mach0gr/renegade-stick/photos/complete-quickterms.jpg

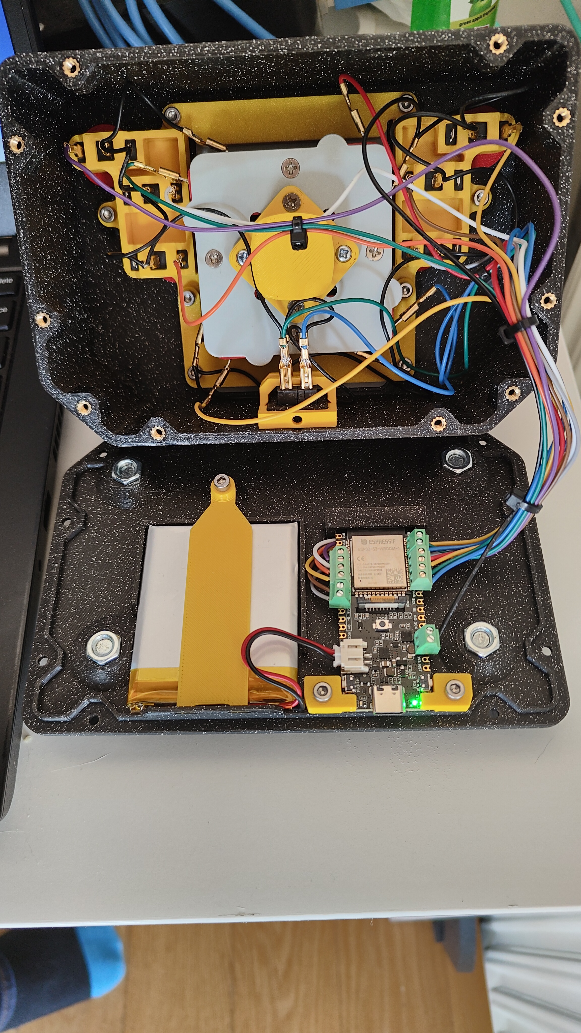
photos/complete-quickterms.jpg
