mach0gr/renegade-stick/photos/quick con diag DFR1075.jpg

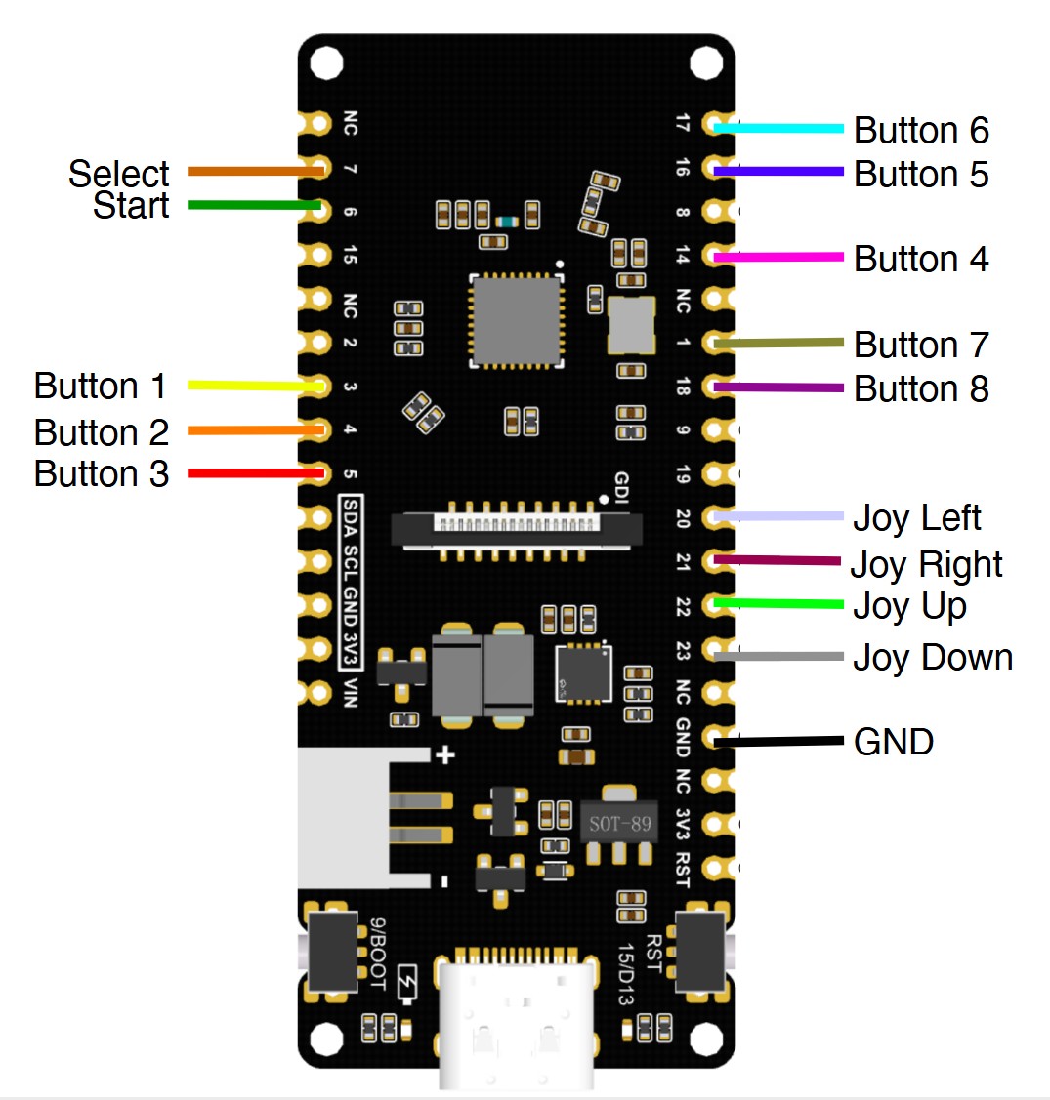
photos/quick con diag DFR1075.jpg
