mach0gr/renegade-stick/photos/quick con diag DFR1139.jpg

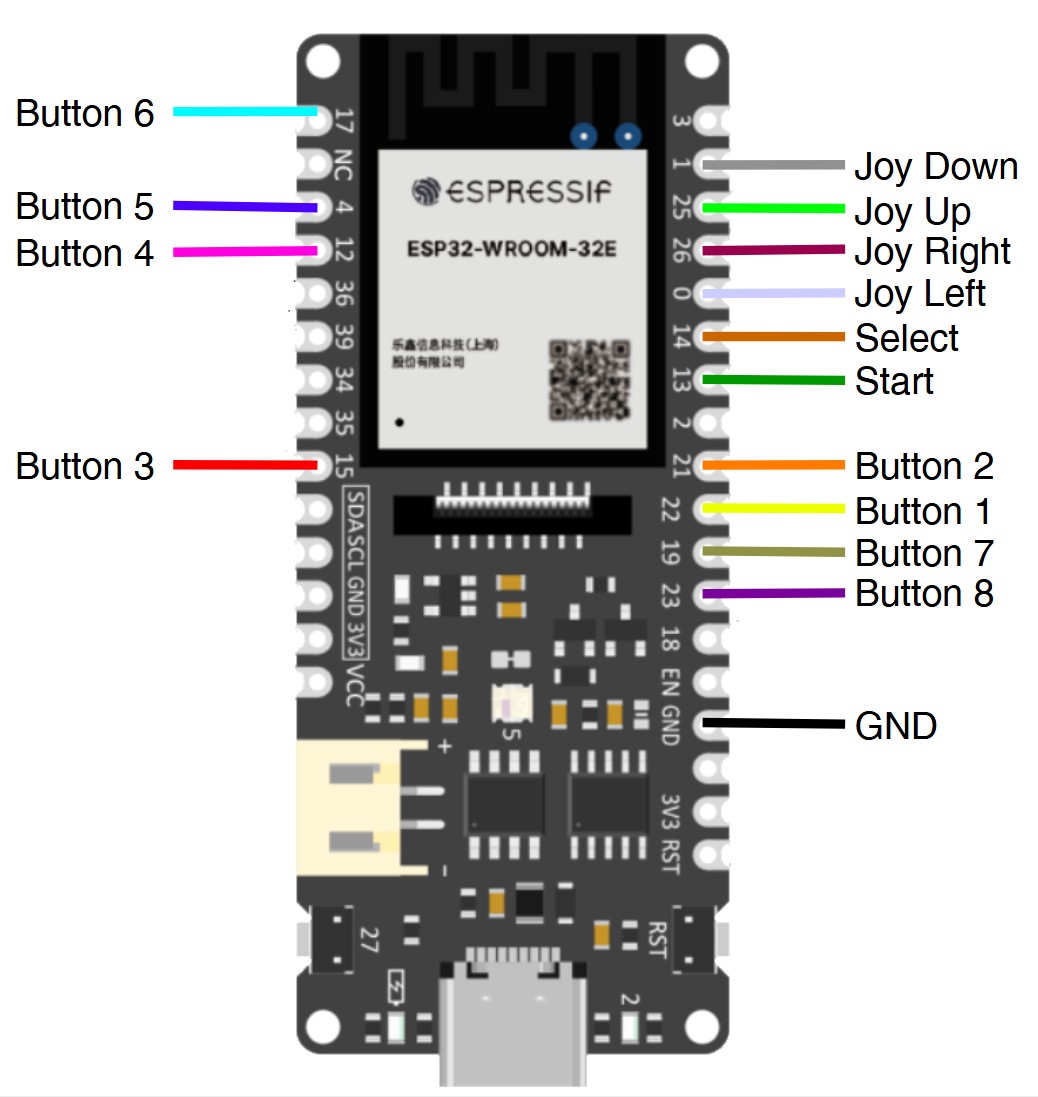
photos/quick con diag DFR1139.jpg
