mach0gr/renegade-stick/photos/quick con diag DFR1145.jpg

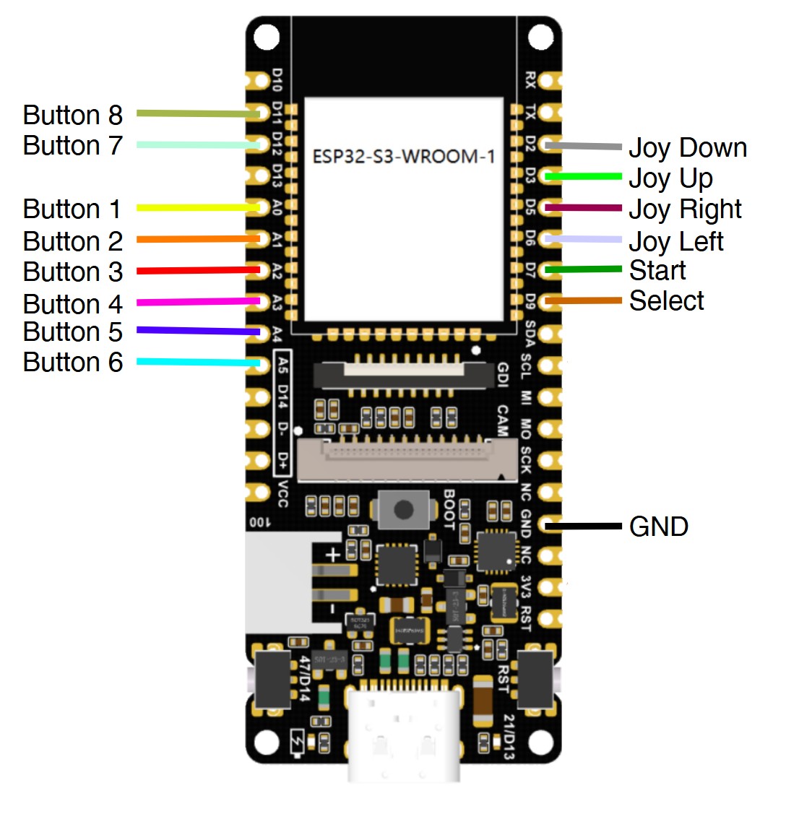
photos/quick con diag DFR1145.jpg
