mach0gr/renegade-stick/photos/renegade stick - circuit diag.jpg

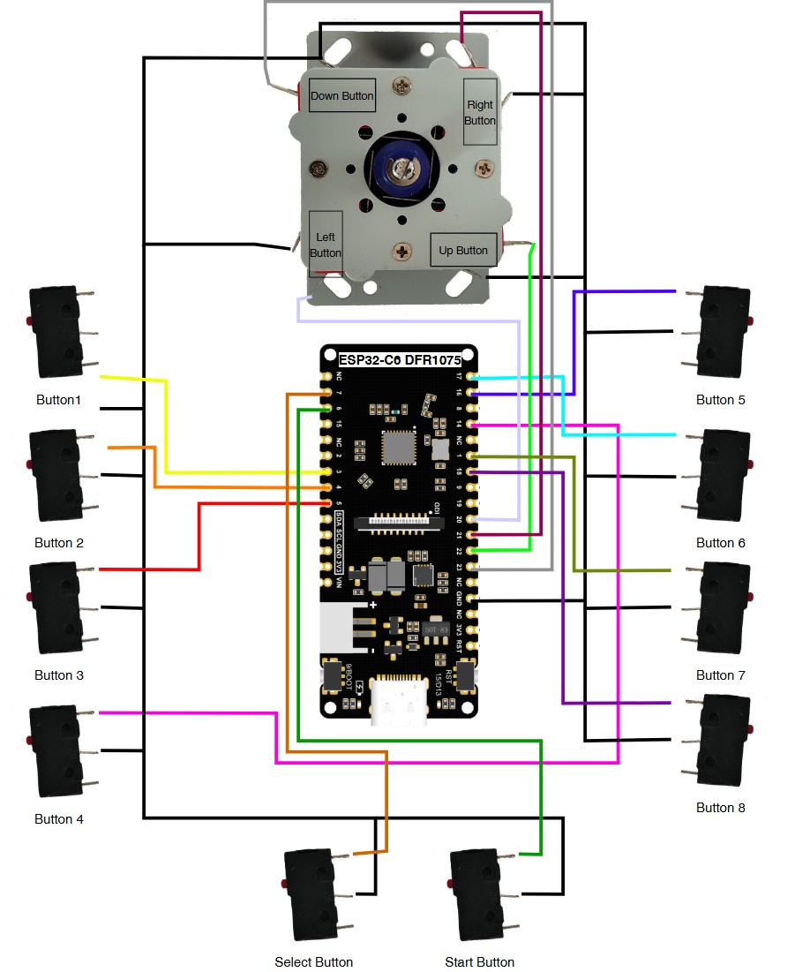
photos/renegade stick - circuit diag.jpg
