mach0gr/renegade-stick/photos/renegade-stick2.jpg

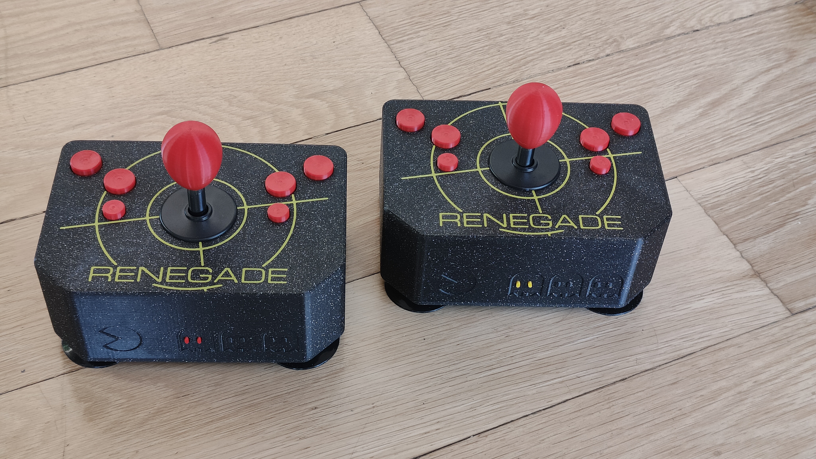
photos/renegade-stick2.jpg
