mach0gr/renegade-stick/photos/BOM.png

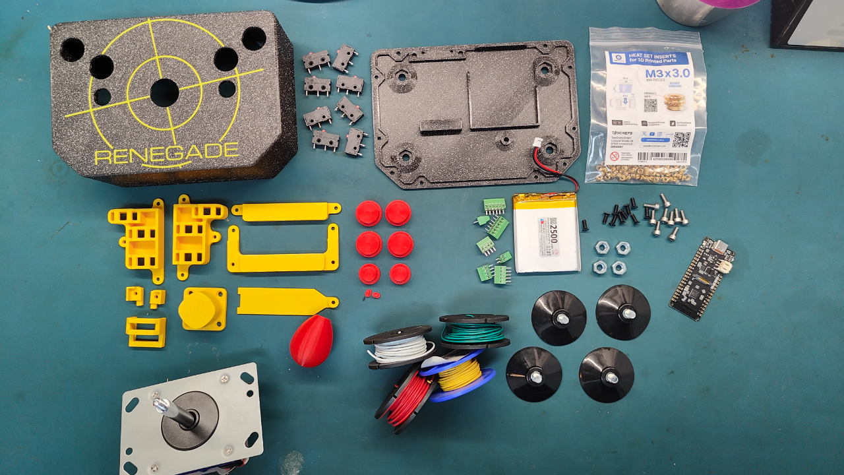
photos/BOM.png
