mach0gr/renegade-stick/photos/complete-soldering.jpg

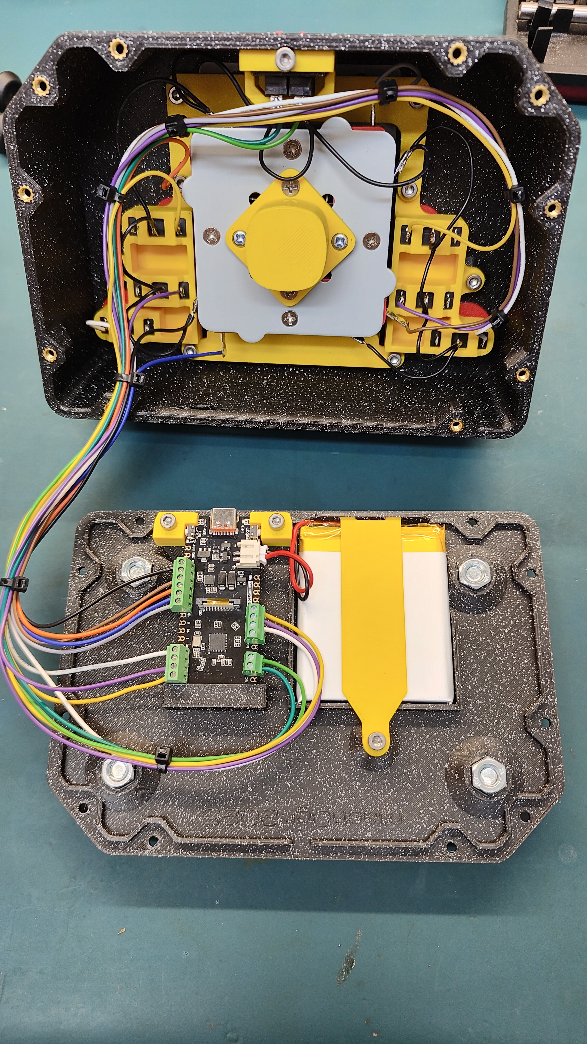
photos/complete-soldering.jpg
