mach0gr/renegade-stick/(commit log)

2025-12-30 updating images and uploading assembly guide
2025-12-30 Update Renegade Stick Assembly Guide.pdf
2025-12-31 adding a couple of photos
2026-01-03 Code Refactor + moved to new 6 button version
2026-01-03 updated guide for 6 button stick
2026-01-05 new 10 button version
2026-01-06 updated photos on assembly guide
2026-01-06 button mapping image
2026-01-06 new button mapping image
2026-01-06 including button mapping image
2026-04-05 new stick and battery alternatives
    Updated item purchase links to include new alternatives for stick and battery
2026-09-13 Add alternative source for suction cup with M6 screw
    Added an alternative source for the suction cup with M6 screw
